sonic-cva6-team/cva6-softcore-contest-sonic/corev_apu/fpga/cva6_fpga.runs/impl_1/.init_design.begin.rst

<?xml version="1.0"?>
<ProcessHandle Version="1" Minor="0">
    <Process Command=".planAhead." Owner="imtuser" Host="" Pid="3654668">
    </Process>
</ProcessHandle>
