sonic-cva6-team/cva6-softcore-contest-sonic/corev_apu/fpga/cva6_fpga.runs/synth_1/.vivado.begin.rst

<?xml version="1.0"?>
<ProcessHandle Version="1" Minor="0">
    <Process Command="vivado" Owner="imtuser" Host="EQI07359" Pid="3653811" HostCore="4" HostMemory="8048784">
    </Process>
</ProcessHandle>
