sonic-cva6-team/cva6-softcore-contest-sonic/sonic_documentation/Template.pptx

Template for Slides

Team Sonic

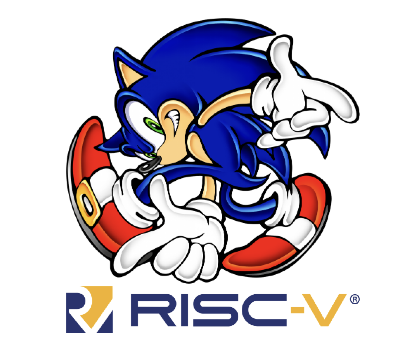
[picture p1: figure]

Martin ROUXEL
Thanh-Thang VO
Oussama MAKNI

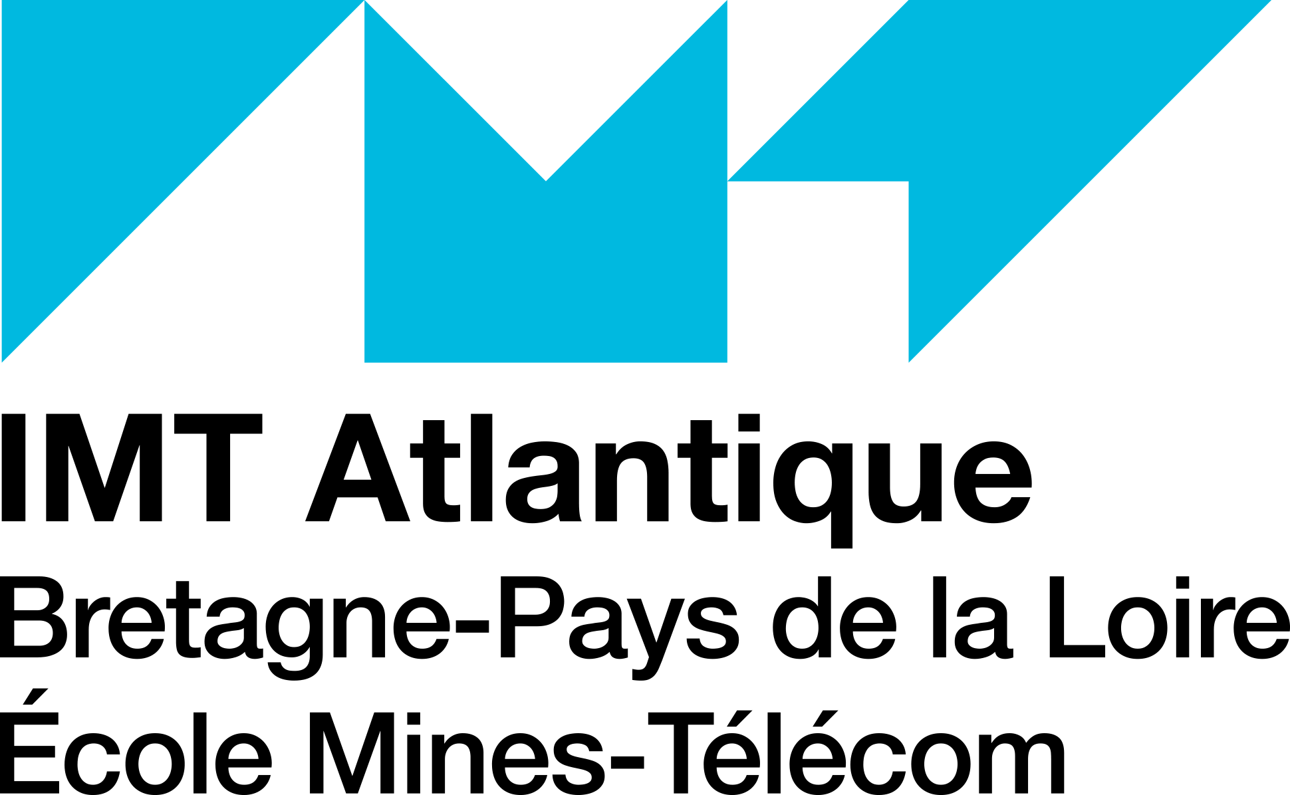
[picture p2: figure]
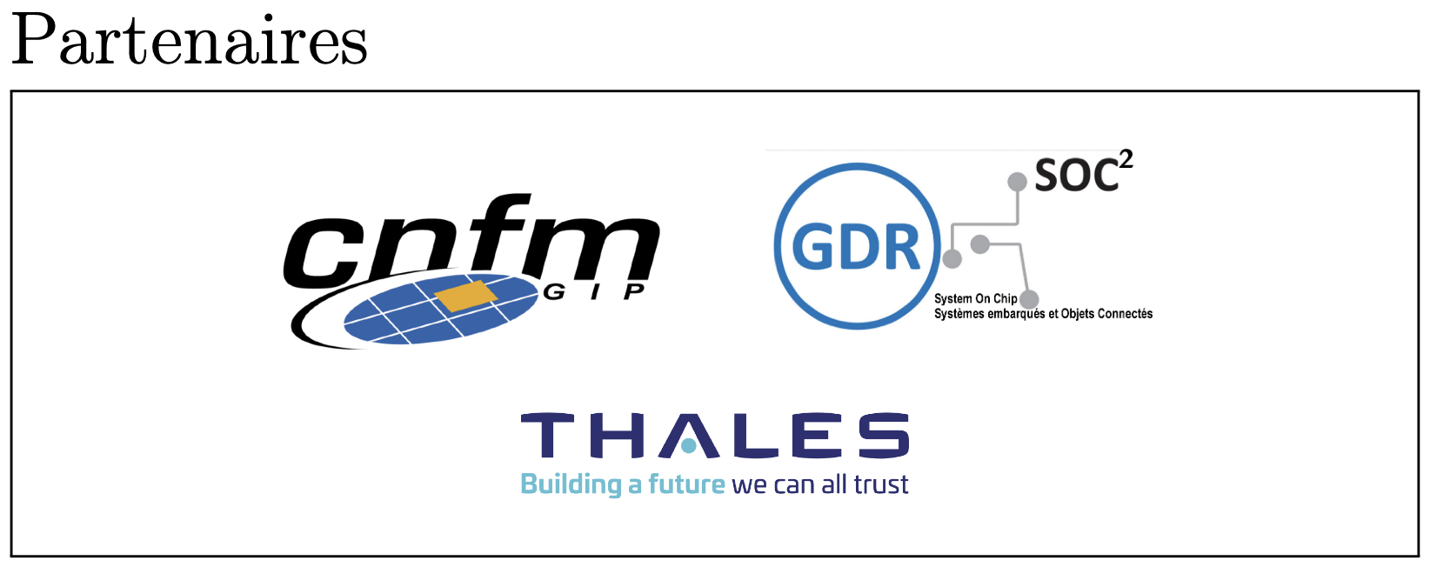
[picture p3: figure]

1

© 2025 IMT Atlantique

## Slide 2

Summary :

- Item 1
- Item 2
- Item 3
- Longer Item 4 That should just keep its head down
- This only takes half the space and should not go any further

Maybe put a figure in there

2

© 2025 IMT Atlantique

## Slide 3

Maybe put a figure in there

All content should always fit and be centered in this black bordered box

Never let anything stick out of it
Then delete the box in all slides at the end
Text should be left aligned and figures should also be placed within the box and given appropriate captions

(a) caption

3

© 2025 IMT Atlantique
