sonic-cva6-team/cva6-softcore-contest-sonic/corev_apu/fpga/cva6_fpga.runs/impl_1/tight_setup_hold_pins.txt

+=======================+=======================+=====================================================================+
| Launch Setup Clock    | Launch Hold Clock     | Pin                                                                 |
+=======================+=======================+=====================================================================+
| clk_out1_xlnx_clk_gen | clk_out1_xlnx_clk_gen | i_ariane/i_cva6/ex_stage_i/lsu_i/lsu_bypass_i/mem_q_reg[0][valid]/D |
| clk_out1_xlnx_clk_gen | clk_out1_xlnx_clk_gen | i_ariane/i_cva6/ex_stage_i/lsu_i/lsu_bypass_i/mem_q_reg[1][valid]/D |
+-----------------------+-----------------------+---------------------------------------------------------------------+
