sonic-cva6-team/cva6-softcore-contest-sonic/corev_apu/fpga/cva6_fpga.runs/synth_1/.Xil/cva6_zybo_z7_20_propImpl.xdc

set_property SRC_FILE_INFO {cfile:/home/imtuser/cva6-sonic/cva6-softcore-contest-sonic-private/corev_apu/fpga/constraints/zybo_z7_20.xdc rfile:../../../constraints/zybo_z7_20.xdc id:1} [current_design]
set_property SRC_FILE_INFO {cfile:/home/imtuser/cva6-sonic/cva6-softcore-contest-sonic-private/corev_apu/fpga/constraints/cva6_fpga.xdc rfile:../../../constraints/cva6_fpga.xdc id:2} [current_design]
set_property src_info {type:XDC file:1 line:1 export:INPUT save:INPUT read:READ} [current_design]
set_property PACKAGE_PIN K17 [get_ports clk_sys]
set_property src_info {type:XDC file:1 line:5 export:INPUT save:INPUT read:READ} [current_design]
set_property -dict {PACKAGE_PIN Y16 IOSTANDARD LVCMOS33} [get_ports cpu_reset]
set_property src_info {type:XDC file:1 line:8 export:INPUT save:INPUT read:READ} [current_design]
set_property -dict {PACKAGE_PIN V13 IOSTANDARD LVCMOS33} [get_ports trst_n]
set_property src_info {type:XDC file:1 line:9 export:INPUT save:INPUT read:READ} [current_design]
set_property -dict {PACKAGE_PIN H15 IOSTANDARD LVCMOS33} [get_ports tck]
set_property src_info {type:XDC file:1 line:10 export:INPUT save:INPUT read:READ} [current_design]
set_property -dict {PACKAGE_PIN W16 IOSTANDARD LVCMOS33} [get_ports tdi]
set_property src_info {type:XDC file:1 line:11 export:INPUT save:INPUT read:READ} [current_design]
set_property -dict {PACKAGE_PIN J15 IOSTANDARD LVCMOS33} [get_ports tdo]
set_property src_info {type:XDC file:1 line:12 export:INPUT save:INPUT read:READ} [current_design]
set_property -dict {PACKAGE_PIN V12 IOSTANDARD LVCMOS33} [get_ports tms]
set_property src_info {type:XDC file:1 line:15 export:INPUT save:INPUT read:READ} [current_design]
set_property -dict {PACKAGE_PIN W8 IOSTANDARD LVCMOS33} [get_ports tx]
set_property src_info {type:XDC file:1 line:16 export:INPUT save:INPUT read:READ} [current_design]
set_property -dict {PACKAGE_PIN U7 IOSTANDARD LVCMOS33} [get_ports rx]
set_property src_info {type:XDC file:2 line:4 export:INPUT save:INPUT read:READ} [current_design]
set_input_jitter tck 1.000
set_property src_info {type:XDC file:2 line:5 export:INPUT save:INPUT read:READ} [current_design]
set_property CLOCK_DEDICATED_ROUTE FALSE [get_nets tck_IBUF]
set_property src_info {type:XDC file:2 line:14 export:INPUT save:INPUT read:READ} [current_design]
set_max_delay -datapath_only -from [get_pins i_dmi_jtag/i_dmi_cdc/i_cdc_resp/i_src/data_src_q_reg*/C] -to [get_pins i_dmi_jtag/i_dmi_cdc/i_cdc_resp/i_dst/data_dst_q_reg*/D] 20.000
set_property src_info {type:XDC file:2 line:15 export:INPUT save:INPUT read:READ} [current_design]
set_max_delay -datapath_only -from [get_pins i_dmi_jtag/i_dmi_cdc/i_cdc_resp/i_src/req_src_q_reg/C] -to [get_pins i_dmi_jtag/i_dmi_cdc/i_cdc_resp/i_dst/req_dst_q_reg/D] 20.000
set_property src_info {type:XDC file:2 line:16 export:INPUT save:INPUT read:READ} [current_design]
set_max_delay -datapath_only -from [get_pins i_dmi_jtag/i_dmi_cdc/i_cdc_req/i_dst/ack_dst_q_reg/C] -to [get_pins i_dmi_jtag/i_dmi_cdc/i_cdc_req/i_src/ack_src_q_reg/D] 20.000
set_property src_info {type:XDC file:2 line:20 export:INPUT save:INPUT read:READ} [current_design]
set_multicycle_path -hold -from [get_pins {i_rstgen_main/i_rstgen_bypass/synch_regs_q_reg[3]/C}] 3
