sonic-cva6-team/cva6-softcore-contest-sonic/(commit log)

2025-11-10 Ajout du document de formalisation des outils et règles d'équipe
    Ajout du document qui donne les règles à respecter par les membres de
    l'équipe ainsi que les outils à utiliser pour la rédaction et le
    développement.
    Ajout d'un template ppt.
2026-01-29 Fix RAW dependency for RS3 operand when coprocessor is used with CV-X-IF
    [issue_read_operands.sv]
2026-01-29 Correct a bug causing questa to throw an error when loading the coprocessor
    [instr_decoder.sv]
2026-01-29 Add check in ID stage before driving signals from RVC related logic
2026-02-04 Brought Thang's ALU to correct computation for golden set
    NEW ALU COPROCESSOR
    C_MUL, C_SUB, C_ADD, C_ADD_ROT, C_SUB_ROT
    30+% performance gain over baseline
    Added way to run multiple ffts for performance analysis as well
    (FFT_BENCHMARK define in main program)
    [copro_alu.sv, cvxif_instr_pkg.sv]
